bbrussel/Stewart_Platform/Bowen Code 2023/stewart-platform-dashboard/data/img/platform_real.png

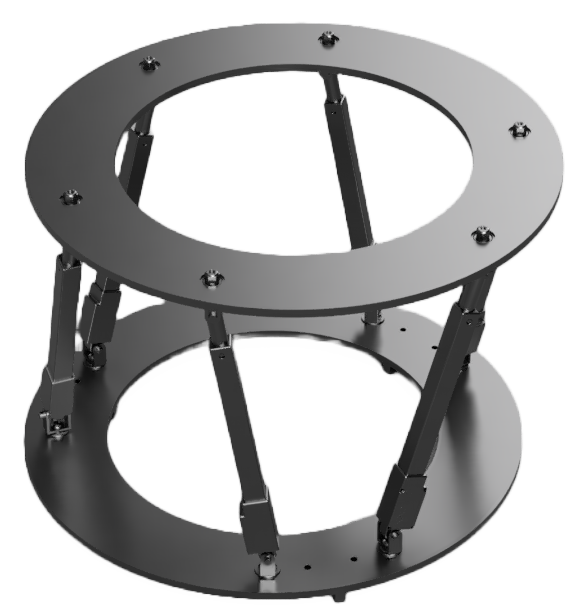
Bowen Code 2023/stewart-platform-dashboard/data/img/platform_real.png
