bbrussel/Stewart_Platform/Bowen Code 2023/stewart-platform-dashboard/image.png

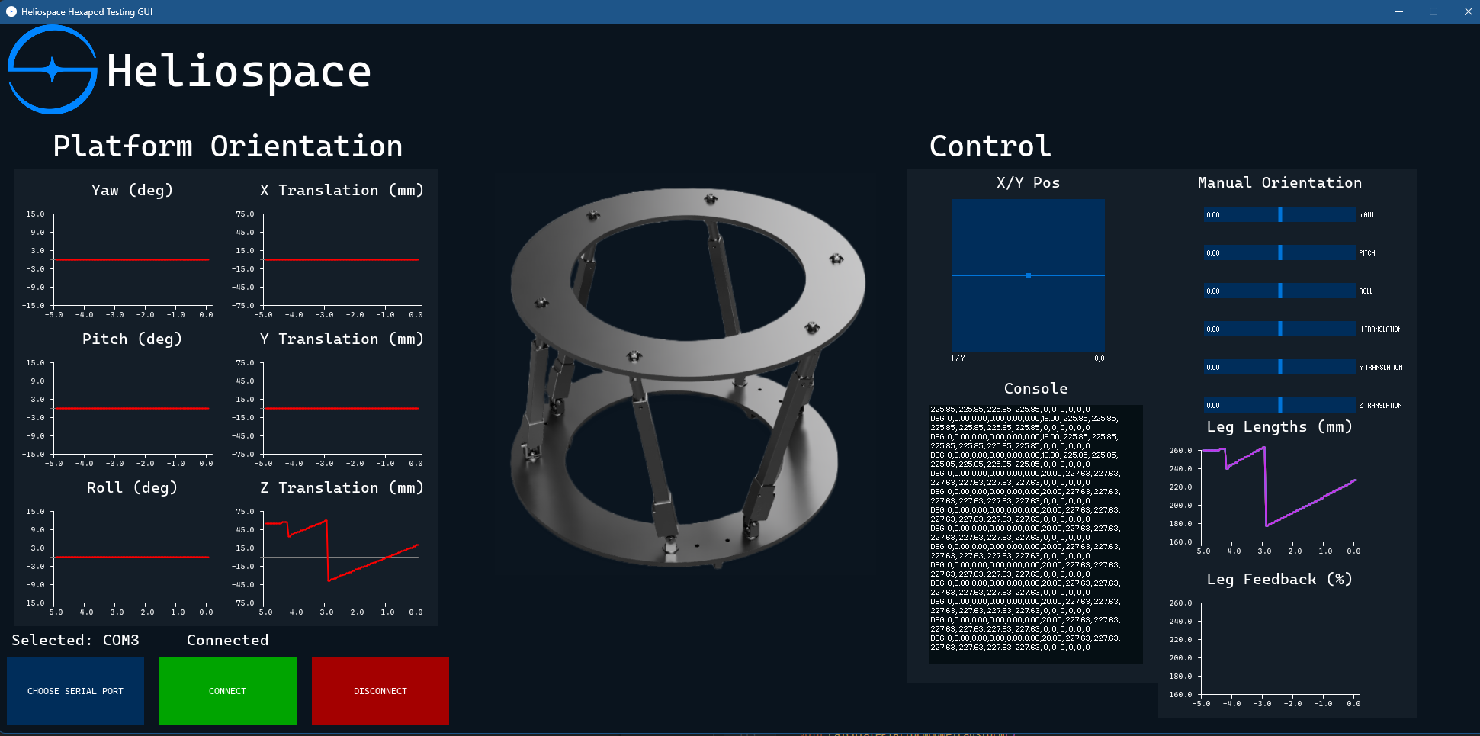
Bowen Code 2023/stewart-platform-dashboard/image.png
