bbrussel/Stewart_Platform/(list of files, cad)

Other CAD files:
3D Printer Files/Hexapod Assembly (v6~recovered).f3z
