bbrussel/Stewart_Platform/Bowen Code 2023/stewart-platform-controller/hexapod-controller.kicad_pcb

## KiCad design Bowen Code 2023/stewart-platform-controller/hexapod-controller.kicad_pcb (2025-09-29)

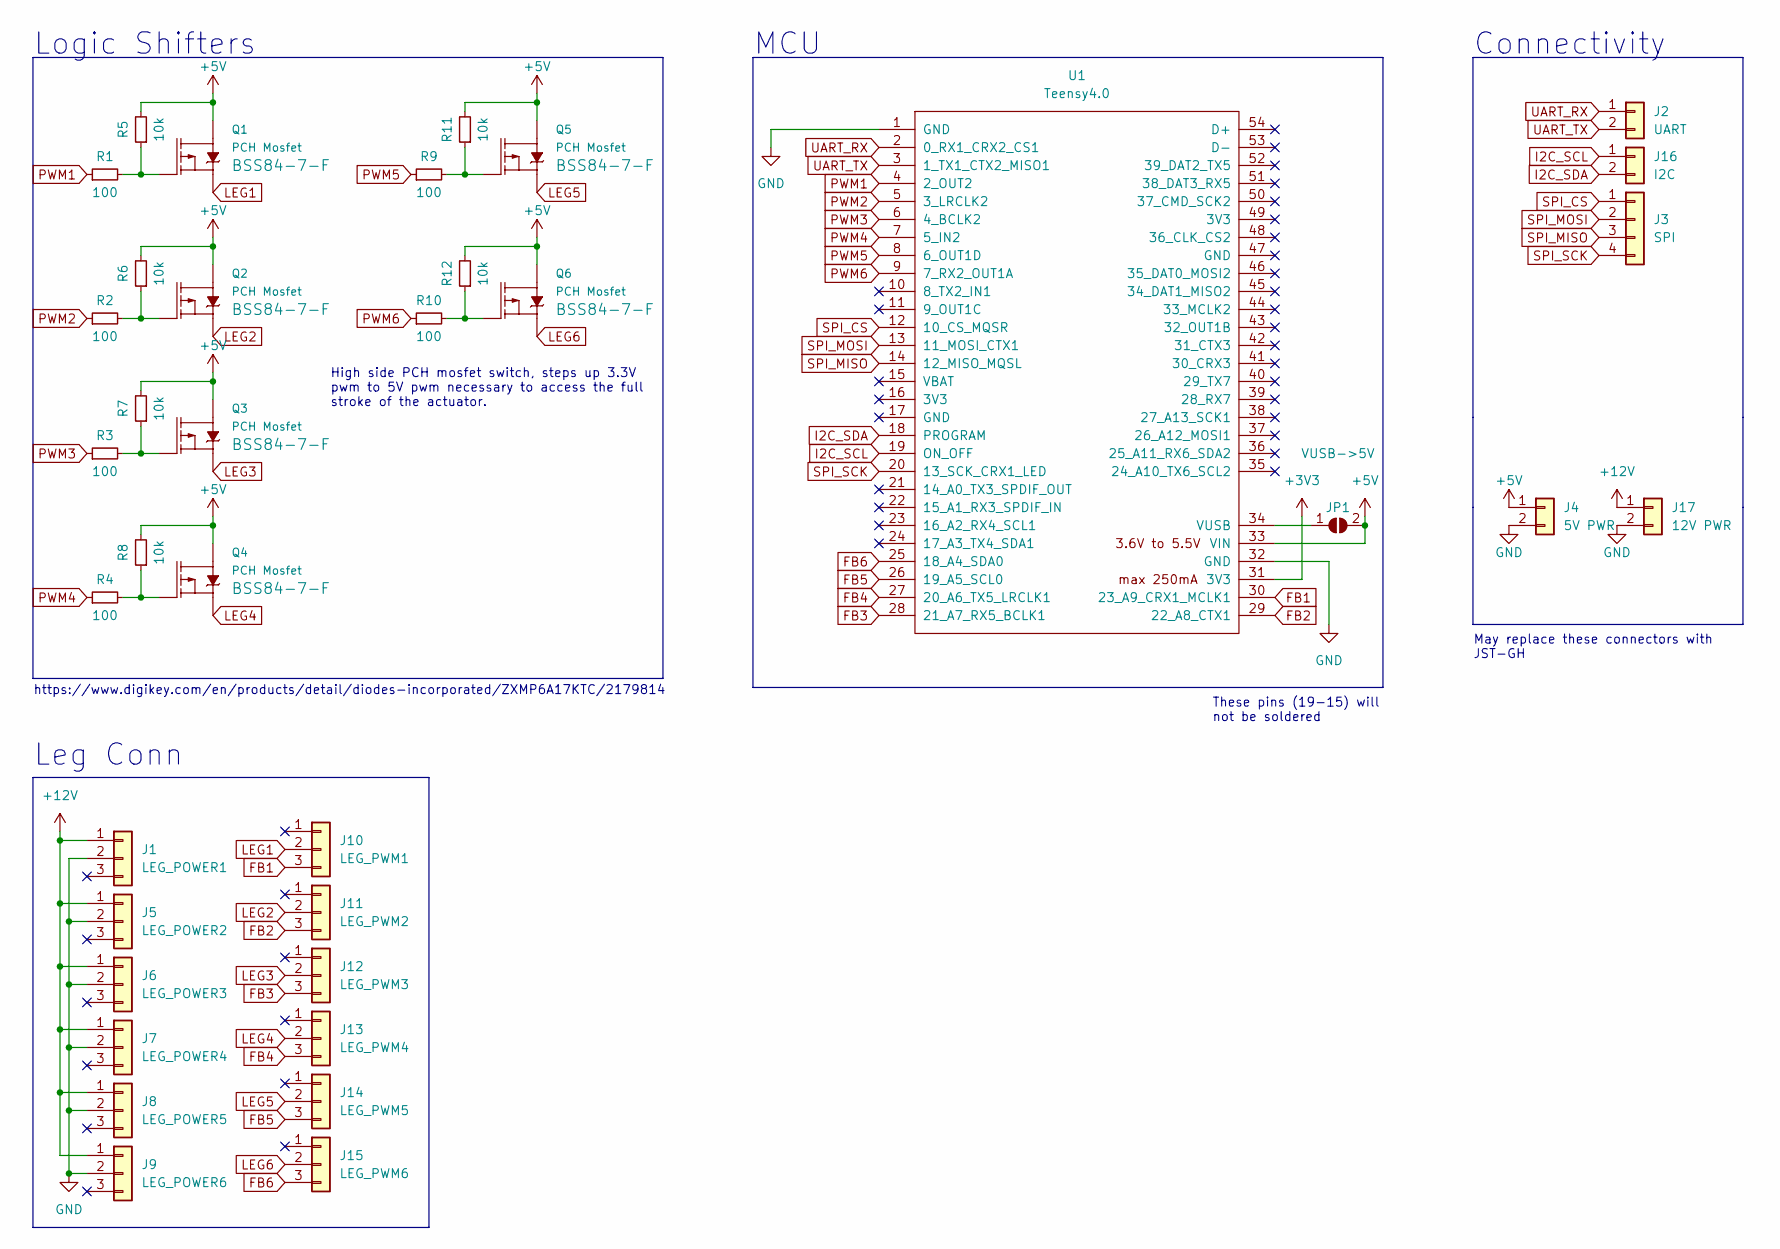
[picture p3: schematic hexapod-controller.kicad_sch]

Parts:
J1: LEG_POWER1; PinHeader_1x03_P2.54mm_Vertical
J2: UART; PinHeader_1x02_P2.54mm_Vertical
J3: SPI; PinHeader_1x04_P2.54mm_Vertical
J4: 5V PWR; PinHeader_1x02_P2.54mm_Vertical
J5: LEG_POWER2; PinHeader_1x03_P2.54mm_Vertical
J6: LEG_POWER3; PinHeader_1x03_P2.54mm_Vertical
J7: LEG_POWER4; PinHeader_1x03_P2.54mm_Vertical
J8: LEG_POWER5; PinHeader_1x03_P2.54mm_Vertical
J9: LEG_POWER6; PinHeader_1x03_P2.54mm_Vertical
J10: LEG_PWM1; PinHeader_1x03_P2.54mm_Vertical
J11: LEG_PWM2; PinHeader_1x03_P2.54mm_Vertical
J12: LEG_PWM3; PinHeader_1x03_P2.54mm_Vertical
J13: LEG_PWM4; PinHeader_1x03_P2.54mm_Vertical
J14: LEG_PWM5; PinHeader_1x03_P2.54mm_Vertical
J15: LEG_PWM6; PinHeader_1x03_P2.54mm_Vertical
J16: I2C; PinHeader_1x02_P2.54mm_Vertical
J17: 12V PWR; PinHeader_1x02_P2.54mm_Vertical
JP1: VUSB->5V; SolderJumper-2_P1.3mm_Open_TrianglePad1.0x1.5mm
Q1, Q2, Q3, Q4, Q5, Q6: PCH Mosfet; SOT-23-3
R1, R2, R3, R4, R9, R10: 100; R_0402_1005Metric
R5, R6, R7, R8, R11, R12: 10k; R_0402_1005Metric
U1: Teensy4.0; Teensy40_SMT

Connections:
+3V3: U1.31 (3V3)
+5V: J4.1, JP1.2 (B), Q1.3 (D), Q2.3 (D), Q3.3 (D), Q4.3 (D), Q5.3 (D), Q6.3 (D), R5.2, R6.2, R7.2, R8.2, R11.2, R12.2, U1.33 (VIN)
+12V: J1.1, J5.1, J6.1, J7.1, J8.1, J9.1, J17.1
FB1: J10.3, U1.30 (23_A9_CRX1_MCLK1)
FB2: J11.3, U1.29 (22_A8_CTX1)
FB3: J12.3, U1.28 (21_A7_RX5_BCLK1)
FB4: J13.3, U1.27 (20_A6_TX5_LRCLK1)
FB5: J14.3, U1.26 (19_A5_SCL0)
FB6: J15.3, U1.25 (18_A4_SDA0)
GND: J1.2, J4.2, J5.2, J6.2, J7.2, J8.2, J9.2, J17.2, U1.1 (GND), U1.32 (GND)
I2C_SCL: J16.1, U1.19 (ON_OFF)
I2C_SDA: J16.2, U1.18 (PROGRAM)
LEG1: J10.2, Q1.2 (S)
LEG2: J11.2, Q2.2 (S)
LEG3: J12.2, Q3.2 (S)
LEG4: J13.2, Q4.2 (S)
LEG5: J14.2, Q5.2 (S)
LEG6: J15.2, Q6.2 (S)
unnamed: JP1.1 (A), U1.34 (VUSB)
unnamed: Q1.1 (G), R1.2, R5.1
unnamed: Q2.1 (G), R2.2, R6.1
unnamed: Q3.1 (G), R3.2, R7.1
unnamed: Q4.1 (G), R4.2, R8.1
unnamed: Q5.1 (G), R9.2, R11.1
unnamed: Q6.1 (G), R10.2, R12.1
PWM1: R1.1, U1.4 (2_OUT2)
PWM2: R2.1, U1.5 (3_LRCLK2)
PWM3: R3.1, U1.6 (4_BCLK2)
PWM4: R4.1, U1.7 (5_IN2)
PWM5: R9.1, U1.8 (6_OUT1D)
PWM6: R10.1, U1.9 (7_RX2_OUT1A)
SPI_CS: J3.1, U1.12 (10_CS_MQSR)
SPI_MISO: J3.3, U1.14 (12_MISO_MQSL)
SPI_MOSI: J3.2, U1.13 (11_MOSI_CTX1)
SPI_SCK: J3.4, U1.20 (13_SCK_CRX1_LED)
UART_RX: J2.1, U1.2 (0_RX1_CRX2_CS1)
UART_TX: J2.2, U1.3 (1_TX1_CTX2_MISO1)

Notes on the sheet:
These pins (19-15) will not be soldered
Leg Conn
May replace these connectors with JST-GH
MCU
Connectivity
https://www.digikey.com/en/products/detail/diodes-incorporated/ZXMP6A17KTC/2179814
High side PCH mosfet switch, steps up 3.3V pwm to 5V pwm necessary to access the full stroke of the actuator.
Logic Shifters

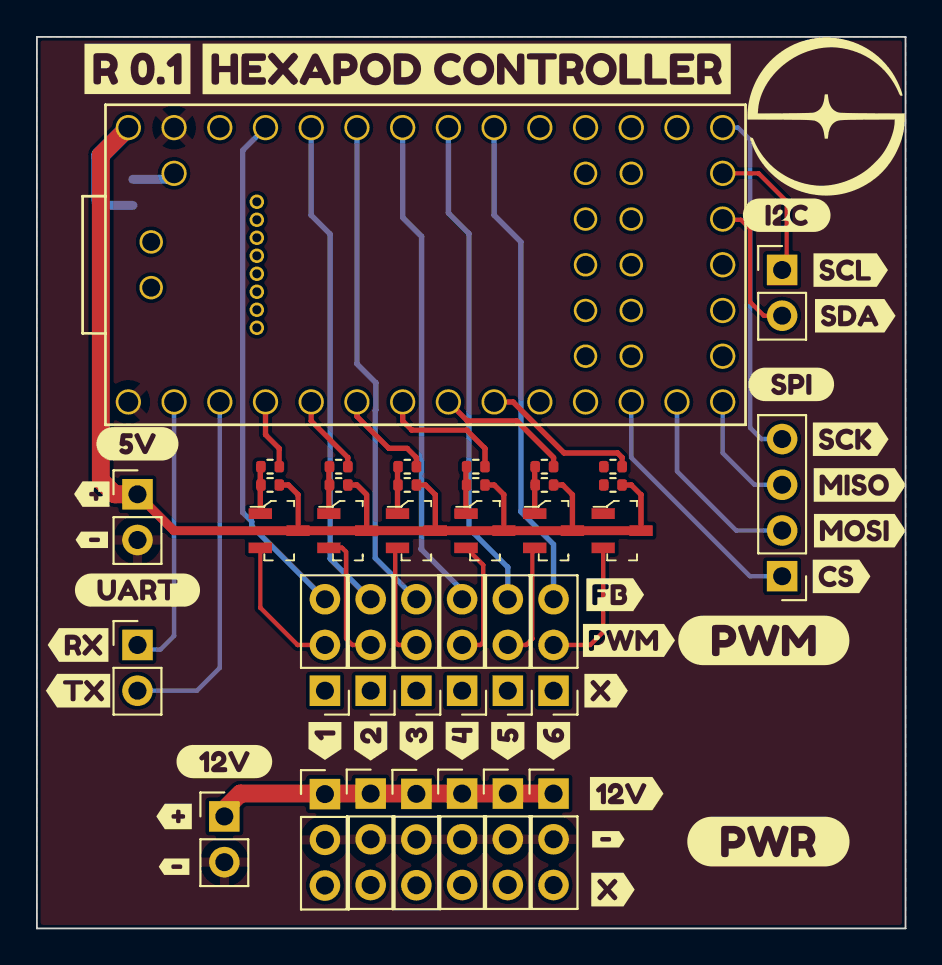
[picture p4: board hexapod-controller.kicad_pcb from above]

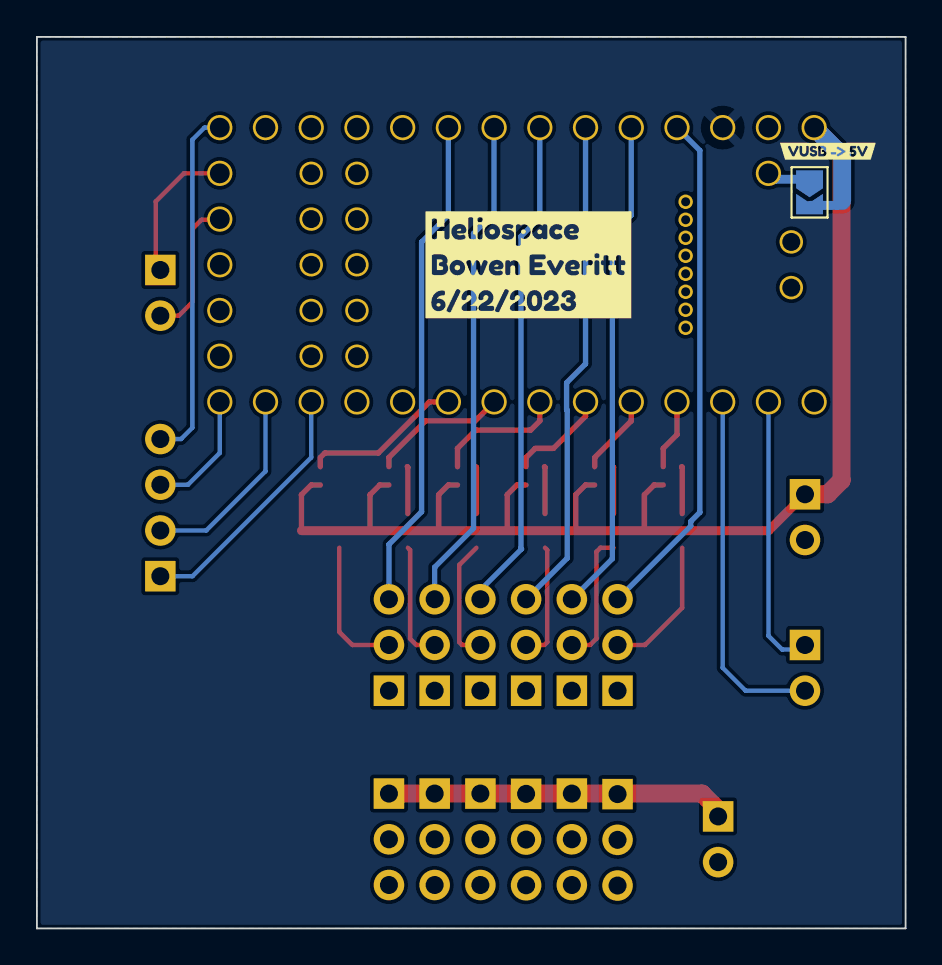
[picture p5: board hexapod-controller.kicad_pcb from below]

Board: 2 copper layers, 48.3 x 49.5 mm, 72 parts (3 on the bottom side), 36 nets.

Other parts of the board:
kibuzzard-64C9A29D: G***; kibuzzard-64C9A29D
kibuzzard-64CAC6D7: G***; kibuzzard-64CAC6D7
kibuzzard-64CAC6FD: G***; kibuzzard-64CAC6FD
kibuzzard-64CAC672: G***; kibuzzard-64CAC672
kibuzzard-64CAE08E: G***; kibuzzard-64CAE08E
kibuzzard-64CAE42C: G***; kibuzzard-64CAE42C
kibuzzard-64CAE079: G***; kibuzzard-64CAE079
kibuzzard-64CAE092, kibuzzard-64CAE092#2: G***; kibuzzard-64CAE092
kibuzzard-64CAE424: G***; kibuzzard-64CAE424
kibuzzard-64D674E6: G***; kibuzzard-64D674E6
kibuzzard-64D674ED: G***; kibuzzard-64D674ED
kibuzzard-64D681E8: G***; kibuzzard-64D681E8
kibuzzard-64D681EE: G***; kibuzzard-64D681EE
kibuzzard-64D681F4: G***; kibuzzard-64D681F4
kibuzzard-64D681FC: G***; kibuzzard-64D681FC
kibuzzard-64D6818E: G***; kibuzzard-64D6818E
kibuzzard-64D68196: G***; kibuzzard-64D68196
kibuzzard-6494A4C2: G***; kibuzzard-6494A4C2
kibuzzard-6494B50A: G***; kibuzzard-6494B50A
kibuzzard-6494B447: G***; kibuzzard-6494B447
kibuzzard-649486BE: G***; kibuzzard-649486BE
kibuzzard-649486D4: G***; kibuzzard-649486D4
kibuzzard-649486DA, kibuzzard-649486DA#2: G***; kibuzzard-649486DA
kibuzzard-649486E4: G***; kibuzzard-649486E4
kibuzzard-649486EE: G***; kibuzzard-649486EE
kibuzzard-6494861E: G***; kibuzzard-6494861E
kibuzzard-6494862C: G***; kibuzzard-6494862C
kibuzzard-6494871C: G***; kibuzzard-6494871C
kibuzzard-64948619: G***; kibuzzard-64948619
kibuzzard-64948622: G***; kibuzzard-64948622
kibuzzard-64948628: G***; kibuzzard-64948628
kibuzzard-64948630: G***; kibuzzard-64948630
kibuzzard-64948713: G***; kibuzzard-64948713
