bbrussel/Stewart_Platform/stewy driver development/simple_stewart_platform_w_feedback/simple_stewart_platform_w_feedback.ino

const int pwmPinLeg1 = 2; // Choose a PWM pin. Example: Pin 3
const int pwmPinLeg2 = 3; // Choose a PWM pin. Example: Pin 3
const int pwmPinLeg3 = 4; // Choose a PWM pin. Example: Pin 3
const int pwmPinLeg4 = 5; // Choose a PWM pin. Example: Pin 3
const int pwmPinLeg5 = 6; // Choose a PWM pin. Example: Pin 3
const int pwmPinLeg6 = 7; // Choose a PWM pin. Example: Pin 3
const int pwmFreqHz = 1000; // Choose a PWM Frequency

const int feedbackPinLeg1 = A9;
const int feedbackPinLeg2 = A8;
const int feedbackPinLeg3 = A7;
const int feedbackPinLeg4 = A6;
const int feedbackPinLeg5 = A5;
const int feedbackPinLeg6 = A4;

const float referenceVoltage = 3.3; // Define the reference voltage
const int adcResolution = 1023; // ADC resolution for a 10-bit ADC

int leg1FeedbackBits;
float leg1FeedbackVoltage;


class Orientation {
  public:
    float yaw;
    float pitch;
    float roll;
    float xTranslation;
    float yTranslation;
    float zTranslation;

    Orientation(float pitch, float roll, float yaw, float xTranslation, float yTranslation, float zTranslation) {
      this->pitch = pitch;
      this->roll = roll;
      this->yaw = yaw;
      this->xTranslation = xTranslation;
      this->yTranslation = yTranslation;
      this->zTranslation = zTranslation;
    }

    void printOrientation() {
      Serial.print(this->pitch);
      Serial.print(",");
      Serial.print(this->roll);
      Serial.print(",");
      Serial.print(this->yaw);
      Serial.print(",");
      Serial.print(this->xTranslation);
      Serial.print(",");
      Serial.print(this->yTranslation);
      Serial.print(",");
      Serial.println(this->zTranslation);


    }
};


float baseRadius = 220;
float platformRadius = 220;
float actuatorClosedLength = 152.0;
float actuatorFullLength = 252.0;
float baseAnchorAngleDegrees = 32.0;
float platformAnchorAngleDegrees = 50.0;
float refRotationDegrees = 0.0;

float actuatorHomeLength;
float psiB[6];
float psiP[6];

float stroke = (actuatorFullLength - actuatorClosedLength);

Orientation platformOrientation(0.0, 0.0, 0.0, 0.0, 0.0, 0.0);
Orientation baseOrientation(0.0, 0.0, 0.0, 0.0, 0.0, 0.0);

Orientation inputPlatformOrientation = platformOrientation;

float baseAnchorHomeCoords[6][3];
float platformAnchorCoords[6][3];
float platformHomeHeight[6];
float platformHomeTransform[3];

float legLengths[6];

float dutyCycles[6];

bool validInput;
bool strokeTooLongError;
bool strokeTooShortError;
float strokeEndBuffer = 3.0;

//variables for handling input commands from serial port
const byte numChars = 64;
char receivedChars[numChars];   // an array to store the received data
boolean newInputCommand = false;

float inputFloats[6]; // Array to hold the parsed input position floats



void setup() {
  Serial.println("\n\n\n\n\n#################################################\n\nStarting Simple Stewart Controller");
  setupPWMPins();
  Serial.begin(115200);
  actuatorHomeLength = actuatorClosedLength + (stroke/2);
  calculatePsiB(psiB, baseAnchorAngleDegrees, refRotationDegrees);
  calculatePsiP(psiP, platformAnchorAngleDegrees, refRotationDegrees);
  calculateBaseAnchorHomeCoords(baseAnchorHomeCoords, psiB, baseRadius);
  calculatePlatformAnchorCoords(platformAnchorCoords, psiP, platformRadius);
  calculatePlatformHomeTransform(platformHomeTransform, baseAnchorHomeCoords, platformAnchorCoords, actuatorHomeLength);
  calculateLegLengthsAndBase(legLengths, baseAnchorHomeCoords, platformAnchorCoords, platformHomeTransform, baseOrientation, platformOrientation);
  Serial.println("Sending Platform to home position");
  sendPositionToActuators();
  Serial.println("Leg Lengths(mm):");
  printArray(legLengths, 6);
}

void loop() {
  Serial.println("\n\n##################################");
  recvWithEndMarker();
  if (newInputCommand == true) {
        Serial.println(receivedChars);
        validInput = parsePositionInputString(receivedChars, inputFloats, 6);
        if (validInput) {
          Serial.println("Moving Actuators");
          inputPlatformOrientation.pitch = inputFloats[0];
          inputPlatformOrientation.roll = inputFloats[1];
          inputPlatformOrientation.yaw = inputFloats[2];
          inputPlatformOrientation.xTranslation = inputFloats[3];
          inputPlatformOrientation.yTranslation = inputFloats[4];
          inputPlatformOrientation.zTranslation = inputFloats[5];

          // printReceivedInputs();

          calculateLegLengthsAndBase(legLengths, baseAnchorHomeCoords, platformAnchorCoords, platformHomeTransform, baseOrientation, inputPlatformOrientation);

          checkLegLengths(legLengths, strokeTooLongError, strokeTooShortError);

          if ((strokeTooLongError == false) & (strokeTooShortError == false)) {
            platformOrientation = inputPlatformOrientation;
            sendPositionToActuators();
          } else {
            Serial.println("###Stroke Error###");
          }
        } else {
          Serial.println("###Invalid Command Entered###");
        }
        newInputCommand = false;
    }

  leg1FeedbackBits = analogRead(feedbackPinLeg1);

  Serial.println("Current Commanded Platform Position: ");
  platformOrientation.printOrientation();
  Serial.println(leg1FeedbackBits);
  delay(1000);


}
