bbrussel/Stewart_Platform/(commit log)

2025-10-15 updates to arduino driver code and python leg length demo code
2025-10-15 updated leg length algo to allow for multiple poses
2025-10-15 updates to multi position demo in leg lengths algo code
2025-11-19 Updated for firgellie actuator driver commands
